semihiseri/invaderBot/README.md

# invadeableBot
Working directory for artificial invaders bots
