semihiseri/invaderBot/docs/driveWheel3.docx

# DLC: driveWheel3

This is the latest iteration of the driveWheel. Thanks to the the improved motor shaft connection design, you can now deliver more torque to the tracks when needed.

## Assembly Instructions

You will need…

- 1x driveWheel3 hub
- 1x M3x10 screw
- 1x driveWheel3

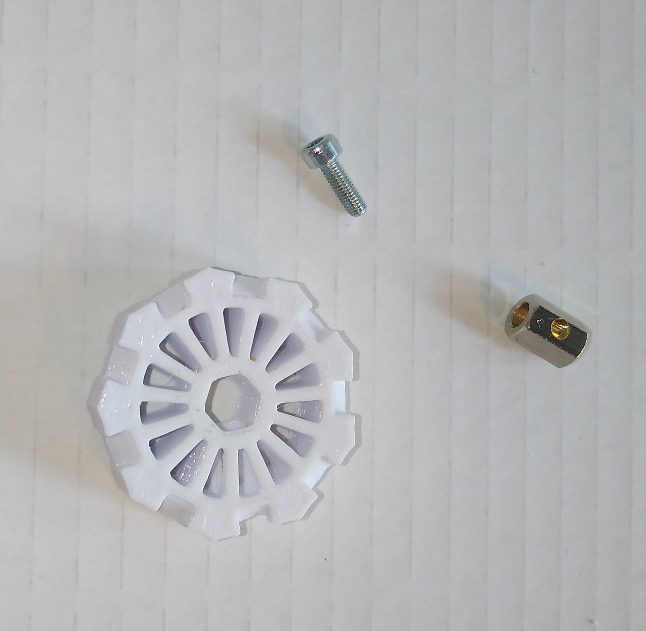
[picture p14: figure]
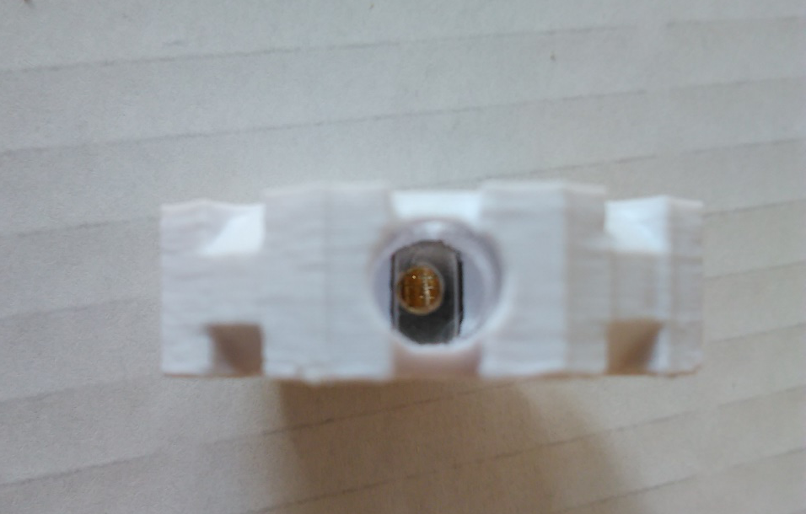
[picture p15: figure]

Align and insert the hub so that you

see the hole through the hole

my finger

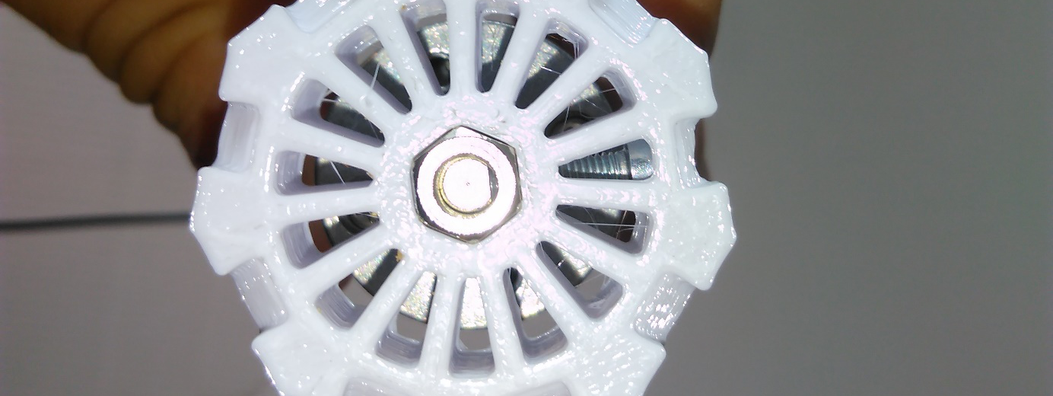
[picture p16: figure]

the flat side of shaft must be

perpendicular to the screw
