semihiseri/invaderBot/tubeAccessories.FCStd

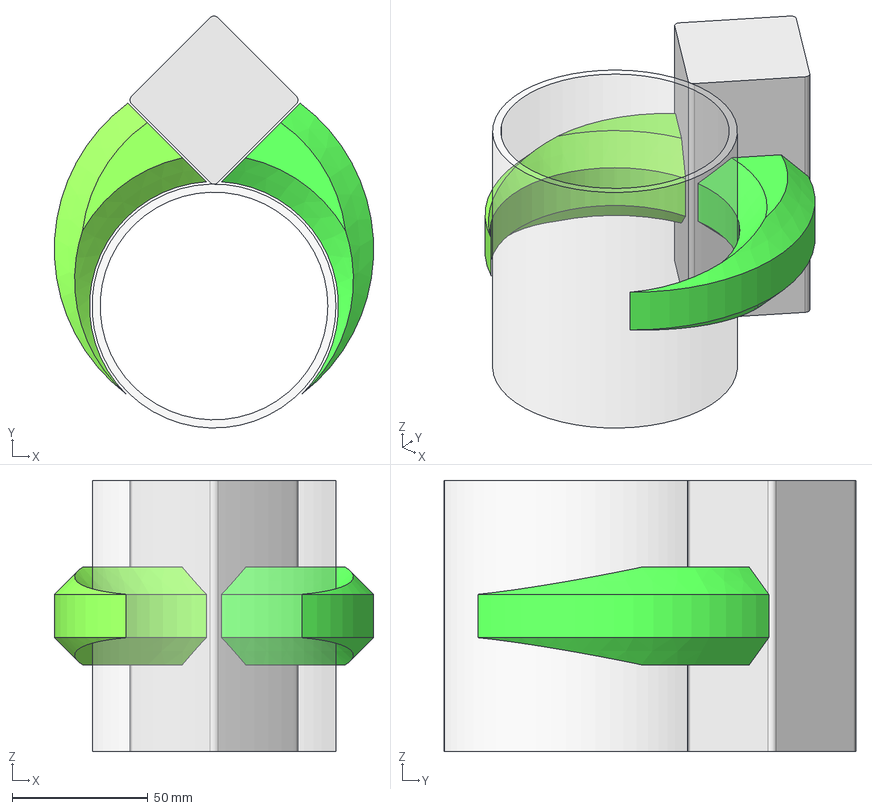
[picture p28: CAD file, 2019-10-02]
tubeAccessories.FCStd
117.7 x 152.0 x 100.0 mm
tube
profile
hand1
