semihiseri/invaderBot/drillTool.FCStd

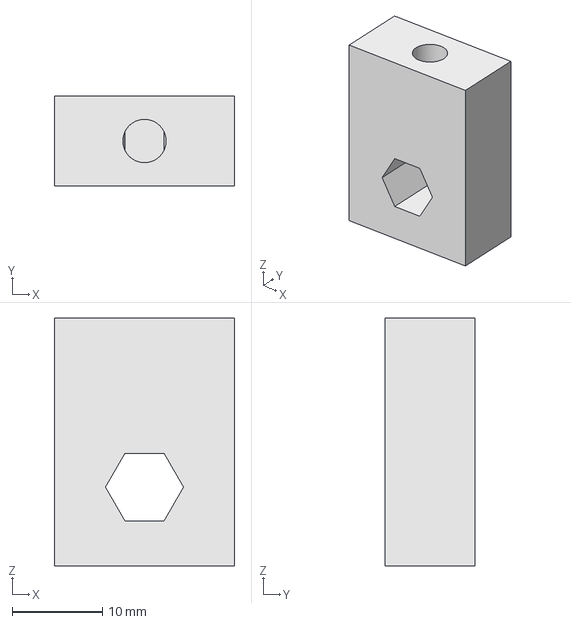
[picture p29: CAD file, 2019-09-19]
drillTool.FCStd
20.0 x 10.0 x 27.5 mm
