semihiseri/invaderBot/driveWheel3.FCStd

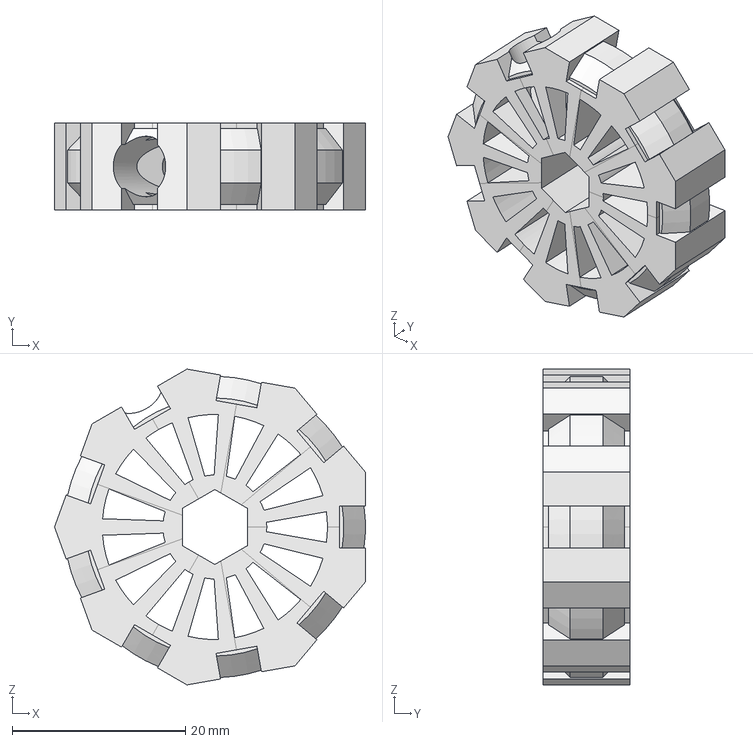
[picture p30: CAD file, 2019-09-19]
driveWheel3.FCStd
35.9 x 10.0 x 36.5 mm
