semihiseri/invaderBot/tensioner2.FCStd

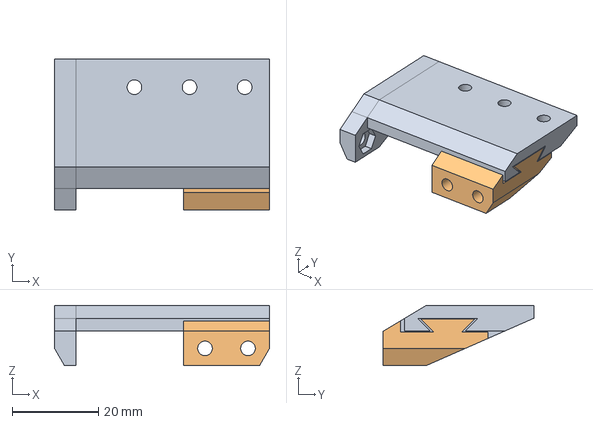
[picture p31: CAD file, 2019-09-15]
tensioner2.FCStd
50.0 x 35.0 x 14.0 mm
rail
slider
