semihiseri/invaderBot/driveWheel2.FCStd

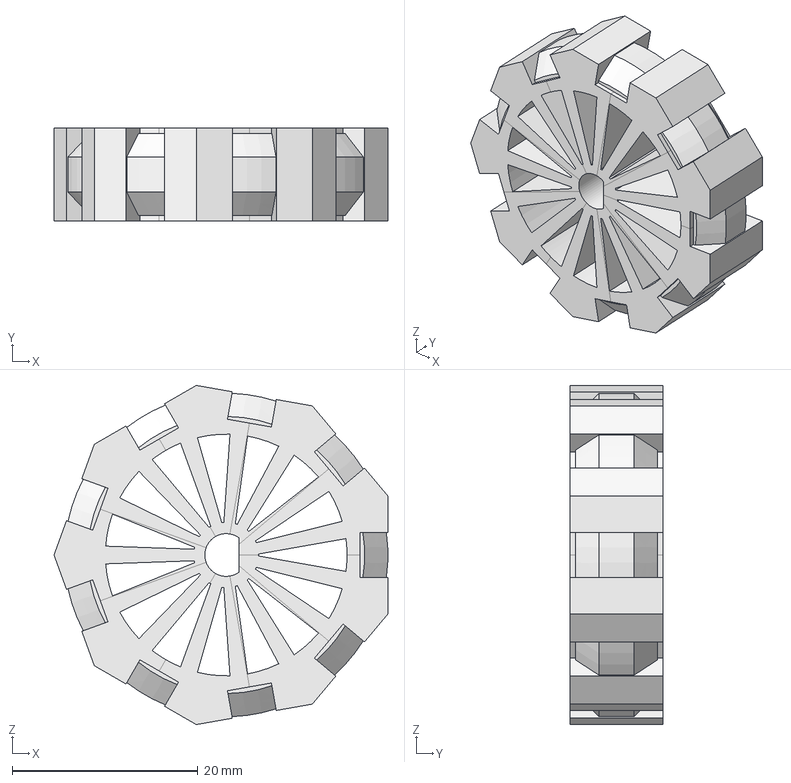
[picture p32: CAD file, 2019-09-03]
driveWheel2.FCStd
35.9 x 10.0 x 36.5 mm
