semihiseri/invaderBot/hinge.FCStd

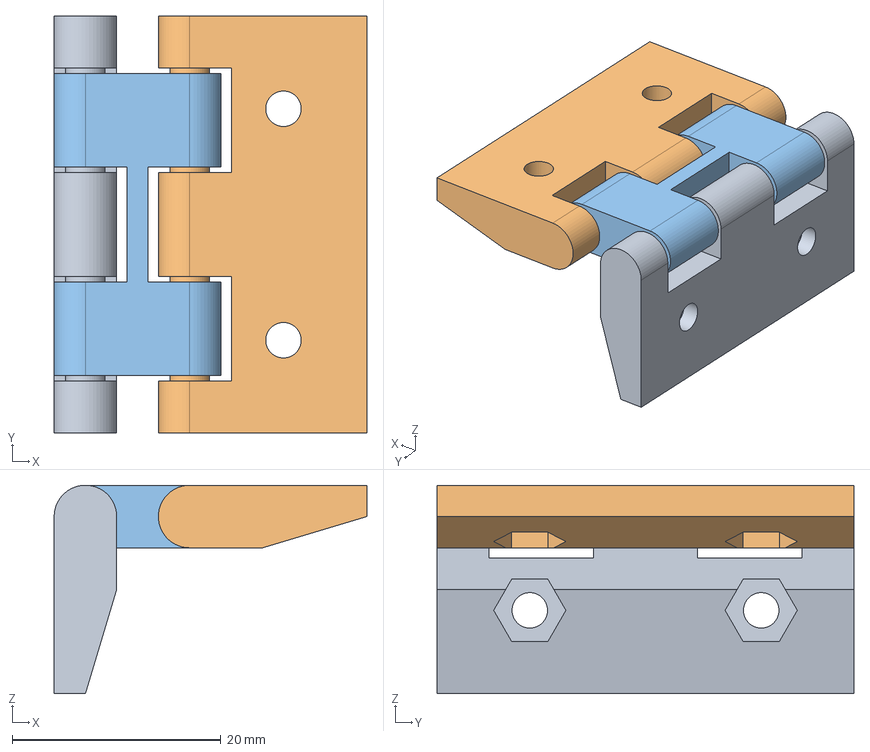
[picture p33: CAD file, 2019-08-29]
hinge.FCStd
30.0 x 40.0 x 20.0 mm
