semihiseri/invaderBot/motorMount3.FCStd

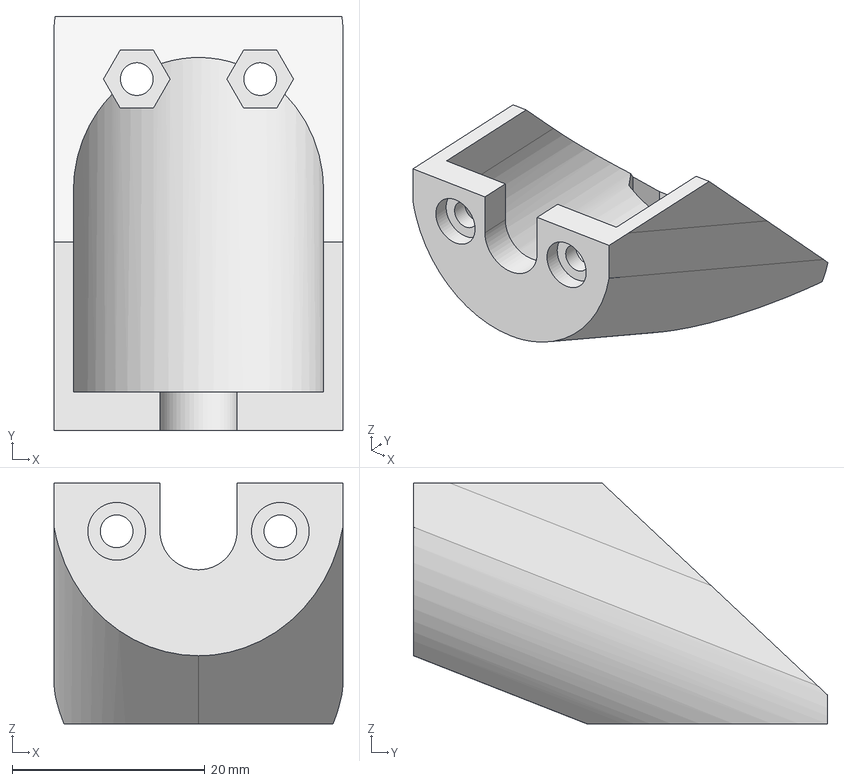
[picture p34: CAD file, 2019-08-29]
motorMount3.FCStd
30.0 x 43.0 x 25.0 mm
