semihiseri/invaderBot/cube2.FCStd

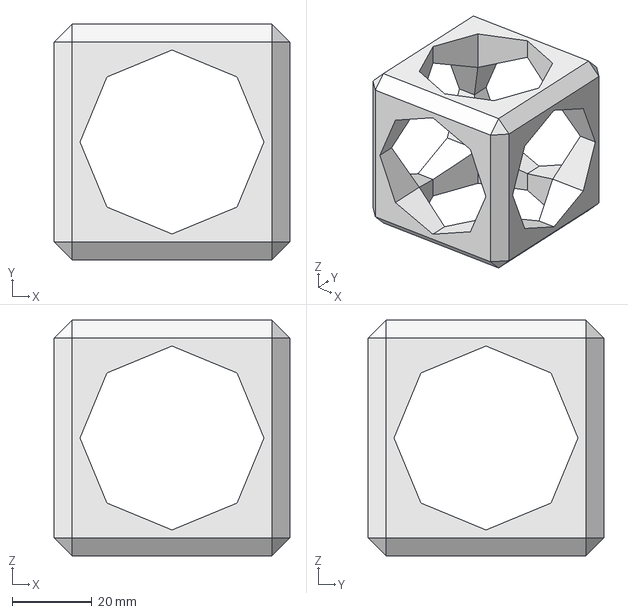
[picture p35: CAD file, 2019-08-04]
cube2.FCStd
59.0 x 59.0 x 59.0 mm
