semihiseri/invaderBot/cube.FCStd

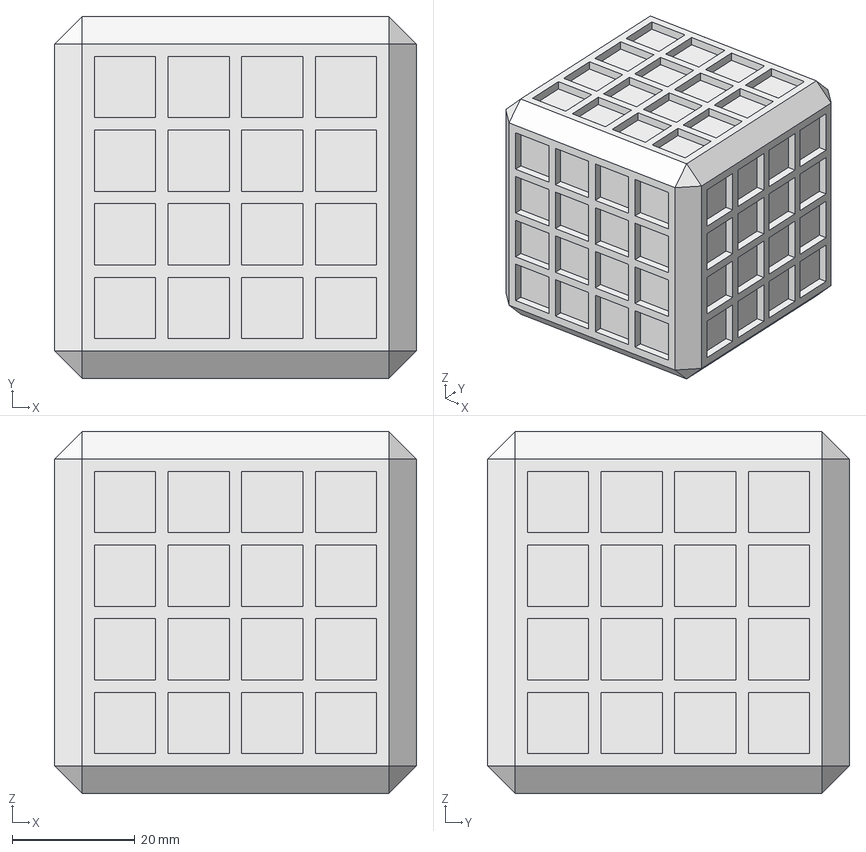
[picture p36: CAD file, 2019-08-04]
cube.FCStd
59.0 x 59.0 x 59.0 mm
