semihiseri/invaderBot/wheel2.FCStd

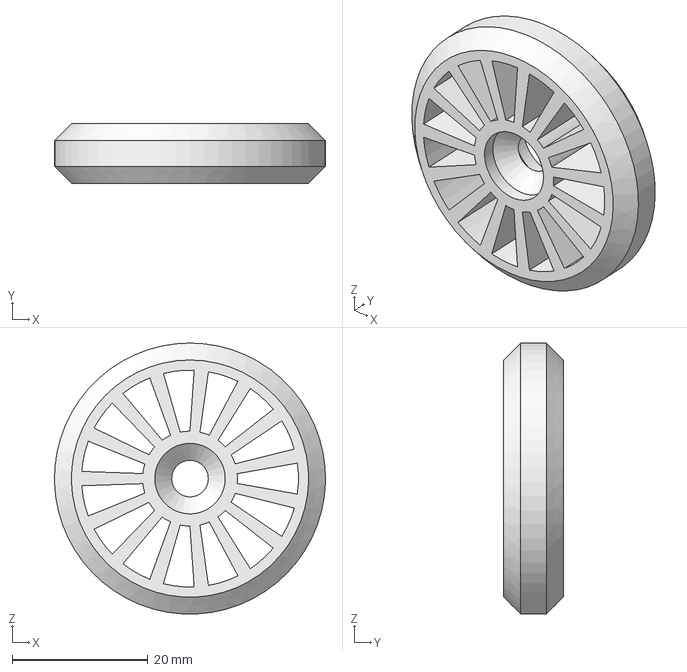
[picture p37: CAD file, 2019-04-27]
wheel2.FCStd
40.0 x 8.80 x 40.0 mm
