semihiseri/invaderBot/track3.FCStd

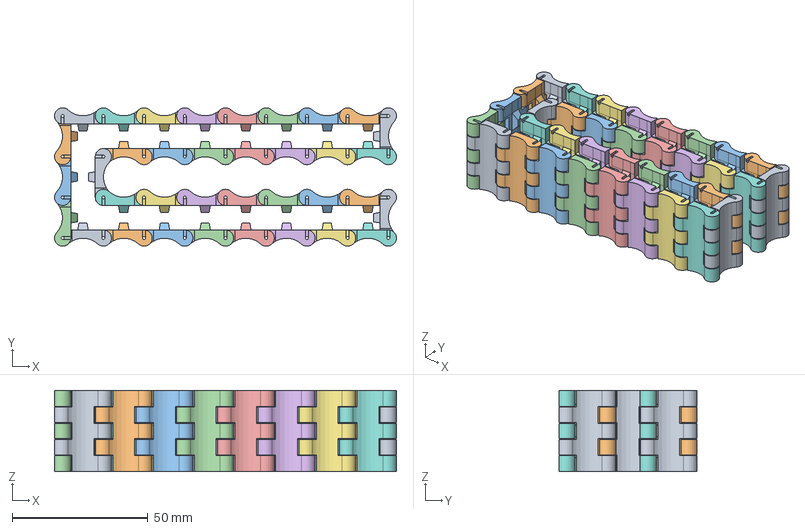
[picture p38: CAD file, 2019-04-27]
track3.FCStd
126.0 x 51.0 x 30.0 mm
