semihiseri/invaderBot/loadBlock.fcstd

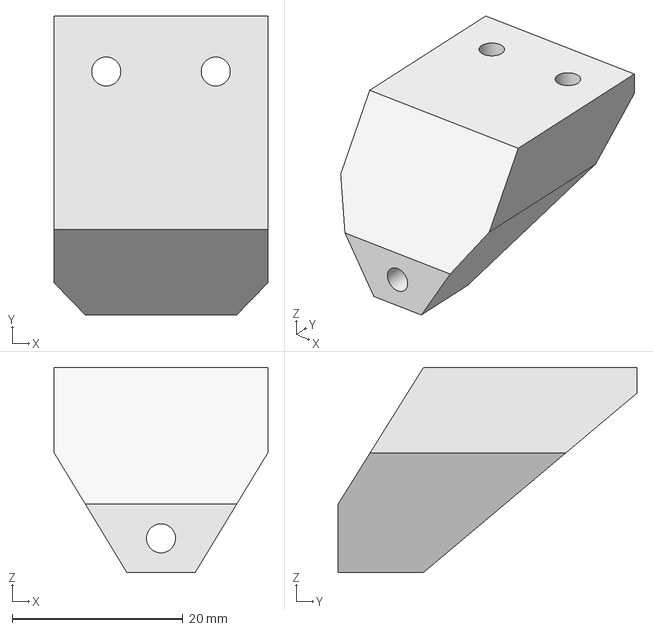
[picture p39: CAD file, 2019-04-27]
loadBlock.fcstd
25.0 x 35.0 x 24.0 mm
