semihiseri/invaderBot/docs/driveWheel3.pdf

## DLC: driveWheel3

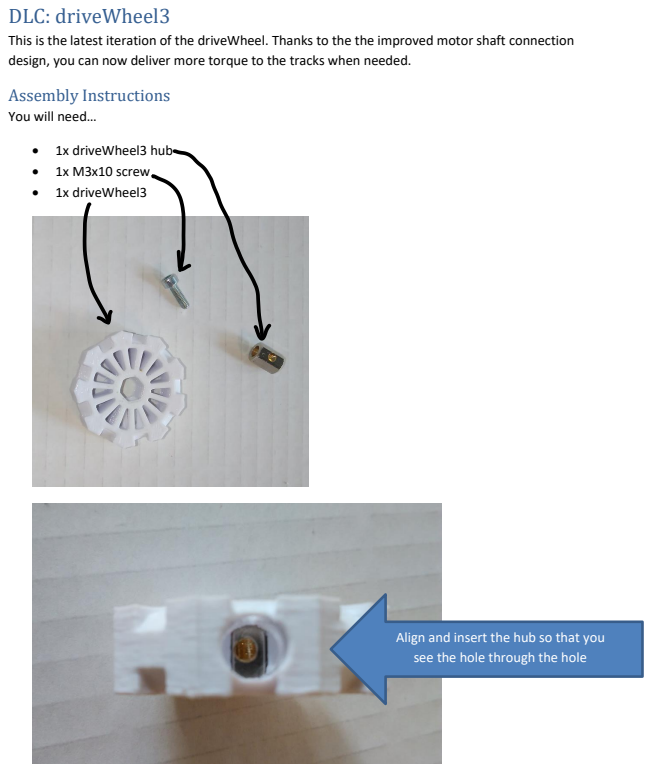
[picture p40: page 1]
• 1x driveWheel3 hub • 1x M3x10 screw • 1x driveWheel3

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

Assembly Instructions
You will need…

Align and insert the hub so that you
see the hole through the hole

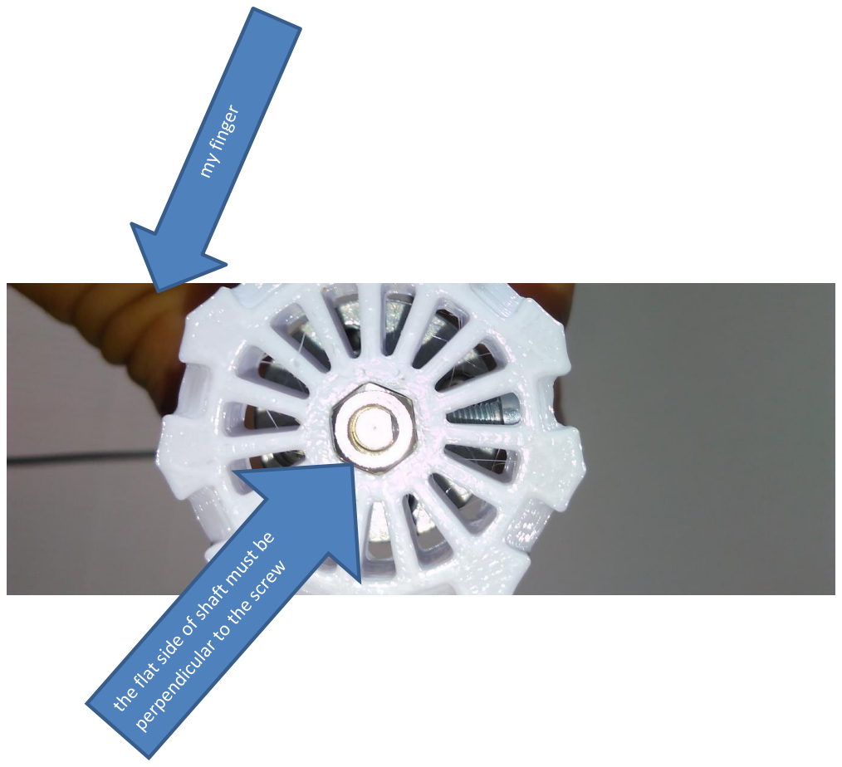
[picture p41: page 2]
