semihiseri/invaderBot/mainboard/autoshutoff-LTspice.asc

C1: cap; 100µ
C2: cap; 30p
R1: res; 100k
V1: voltage; 12
Named nets: 0, HV
.tran 10 startup
