semihiseri/invaderBot/mainboard/invaderBoard.kicad_pcb

## KiCad design mainboard/invaderBoard.kicad_pcb (2019-09-03)

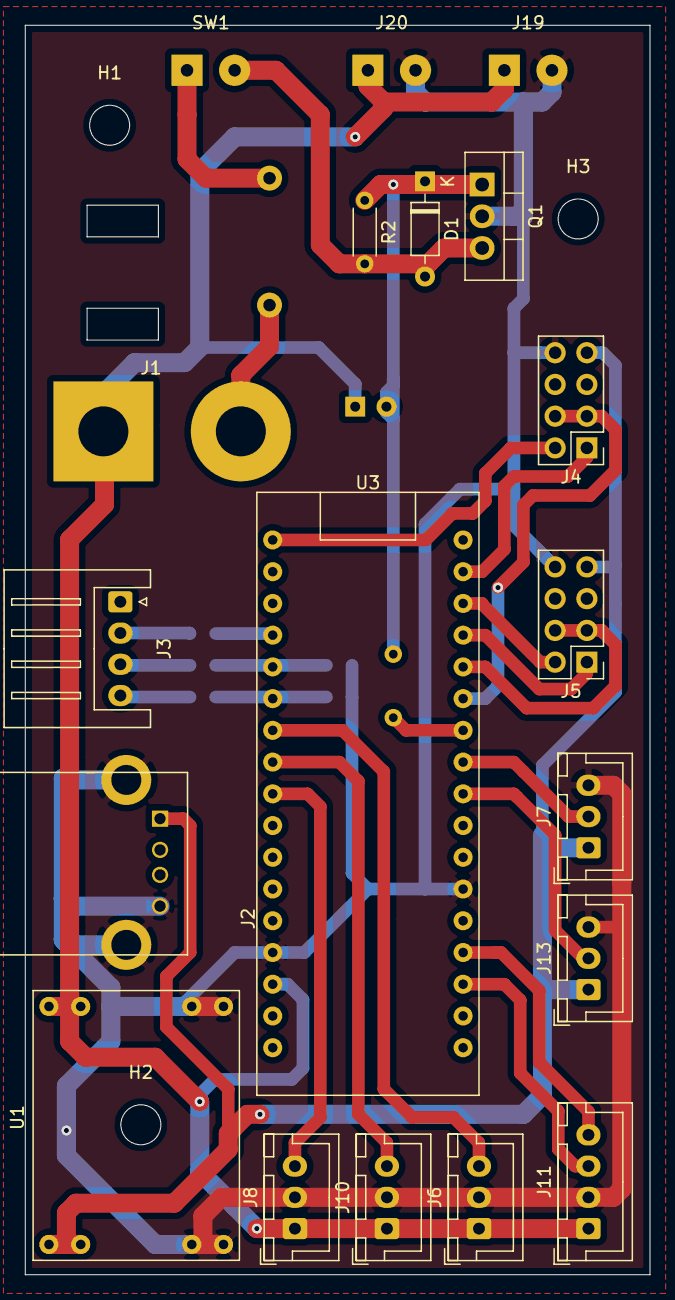
[picture p42: board invaderBoard.kicad_pcb from above]

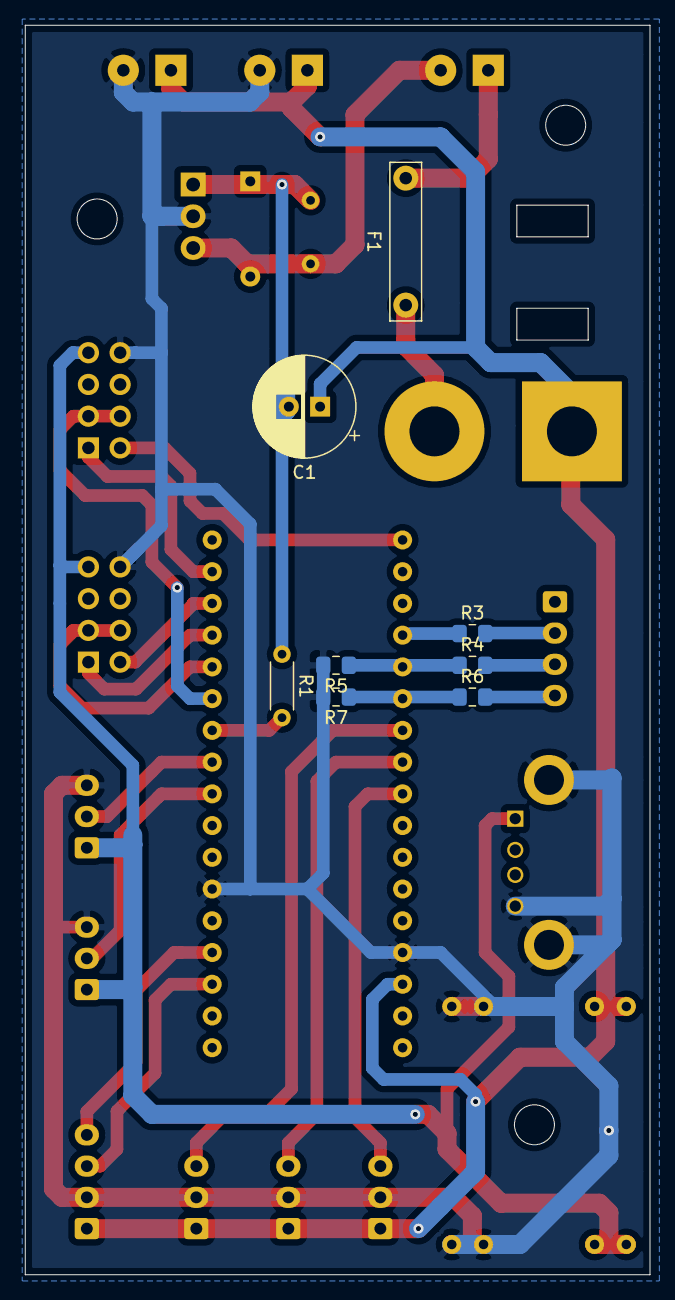
[picture p43: board invaderBoard.kicad_pcb from below]

Board: 2 copper layers, 50.0 x 100.0 mm, 30 parts (8 on the bottom side), 27 nets.

Parts:
C1: C; CP_Radial_D8.0mm_P2.50mm
D1: D; D_DO-35_SOD27_P7.62mm_Horizontal
F1: Polyfuse; PTC Fuse
H1, H2, H3: MountingHole; MountingHole_3.2mm_M3
J1: Conn_01x02; BiggerSolderPad
J2: USB_A
J3: Conn_01x04; JST_XH_S4B-XH-A_1x04_P2.50mm_Horizontal
J4, J5: Conn_02x04_Odd_Even; PinHeader_2x04_P2.54mm_Vertical
J6, J7, J8, J10, J13: Conn_01x03; JST_XH_B3B-XH-A_1x03_P2.50mm_Vertical
J11: Conn_01x04; JST_XH_B4B-XH-A_1x04_P2.50mm_Vertical
J19, J20: Conn_01x02; SolderWirePad_1x02_P3.81mm_Drill1mm
Q1: IRFZ44; TO-220-3_Vertical
R1, R2: R; R_Axial_DIN0204_L3.6mm_D1.6mm_P5.08mm_Horizontal
R3, R4, R5, R6, R7: R; R_0805_2012Metric_Pad1.15x1.40mm_HandSolder
SW1: SW_DIP_x01; SolderWirePad_1x02_P3.81mm_Drill1mm
U1: LM2596
U3: ArduinoMicro; Arduino Micro

Connections:
/5V: J2.1, J4.7, J5.7, J7.1, J13.1, U1.4
/BATT_CELL_1: J3.2, R3.2
/BATT_CELL_2: J3.3, R4.2
/BATT_CELL_3: J3.4, R6.2
/BATT_GND: D1.2, Q1.3, R2.2, SW1.2
/CELL_1: R3.1, U3.4
/CELL_2: R4.1, R5.1, U3.5
/CELL_3: R6.1, R7.1, U3.6
/GND: J2.4, J2.5, J4.8, J5.8, J6.2, J7.3, J8.2, J10.2, J11.2, J13.3, J19.2, J20.2, Q1.2, R5.2, R7.2, U1.1, U1.3, U3.14, U3.23
/HV: C1.1, J1.1, J6.1, J8.1, J10.1, J11.1, J19.1, J20.1, U1.2, U3.15
/LATCH_CTL: R1.2, U3.28
/LIGHT_DIN_1: J13.2, U3.26
/LIGHT_DIN_2: J7.2, U3.27
/M1_DIR: J4.3, J4.4, U3.29
/M1_LPWM: J4.2, U3.1
/M1_RPWM: J4.1, U3.33
/M2_DIR: J5.3, J5.4, U3.30
/M2_LPWM: J5.2, U3.32
/M2_RPWM: J5.1, U3.31
/USER_A3: J6.3, U3.7
/USER_A4: J10.3, U3.8
/USER_A5: J8.3, U3.9
/USER_RX: J11.4, U3.21
/USER_TX: J11.3, U3.20
unnamed: C1.2, D1.1, Q1.1, R1.1, R2.1
unnamed: F1.1, SW1.1
unnamed: F1.2, J1.2
