semihiseri/invaderBot/(commit log)

2019-04-06 track
    print in place track
    [track2.FCStd]
2019-04-27 initial loadblock
    [loadBlock.fcstd]
2019-04-27 track and wheel stuf added
    [track2.FCStd, track3.FCStd, wheel2.FCStd]
2019-04-28 files from old version -> tensioner and D coupling
    [3mmDcoupling.FCStd, tensioner.FCStd]
2019-04-28 new tensioner
    [tensioner.FCStd, tensioner2.FCStd]
2019-04-28 fixed interference between track and slider
    [tensioner2.FCStd]
2019-04-29 invaderboard initial commit
    [invaderBoard.kicad_pcb, invaderBoard.sch]
2019-04-30 kicad version 5 update
    [invaderBoard.sch]
2019-05-01 Motor coupling doned
    [driveWheel.FCStd, n20coupler.FCStd]
2019-05-16 first working combination
    [3mmDcoupling.FCStd, driveWheel.FCStd, driveWheel2.FCStd, motorDriverModel.FCStd, motorMount.FCStd, motorMount2.FCStd, rpiZeroModel.FCStd, tensioner2.FCStd]
2019-05-20 Notes to PCB design
    [invaderBoard.sch]
2019-07-23 Mainboard schematics mostly done
    [invaderBoard.sch]
2019-07-24 PCB mostly done, motor power outputs added to schematics
    [invaderBoard.kicad_pcb, invaderBoard.sch]
2019-08-04 Updated PCB - layout done, routing isn't
    [cube.FCStd, invaderBoard.kicad_pcb, invaderBoard.sch]
2019-08-04 a new cube added
    [cube2.FCStd]
2019-08-05 PCB Done, some changes on schematics
    [invaderBoard.kicad_pcb, invaderBoard.sch]
2019-08-05 PCB holes added + capacitor simulator in LTspice
    [invaderBoard.kicad_pcb, invaderBoard.sch]
2019-08-15 Manuf files created
    [invaderBoard-B_Cu.gbr, invaderBoard-B_Mask.gbr, invaderBoard-B_Paste.gbr, invaderBoard-B_SilkS.gbr, invaderBoard-Edge_Cuts.gbr, invaderBoard-F_Cu.gbr, invaderBoard-F_Mask.gbr, invaderBoard-F_Paste.gbr]
2019-08-29 some changes I guess
    [hinge.FCStd, motorMount3.FCStd]
2019-08-29 arduino FW added + some changes on sch.
    [invaderBoard-B_Cu.gbr, invaderBoard-B_Mask.gbr, invaderBoard-B_Paste.gbr, invaderBoard-B_SilkS.gbr, invaderBoard-Edge_Cuts.gbr, invaderBoard-F_Cu.gbr, invaderBoard-F_Mask.gbr, invaderBoard-F_Paste.gbr]
2019-09-03 PCB updated -v1 finalized
    [driveWheel2.FCStd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]
2019-09-15 Some more changes
    [tensioner2.FCStd]
2019-09-15 improved arduino code
2019-09-16 Obsolete drawings removed
    [motorDriverModel.FCStd, motorMount.FCStd, motorMount2.FCStd, rpiZeroModel.FCStd]
2019-09-16 More obsolete drawings removed
    [driveWheel.FCStd, n20coupler.FCStd]
2019-09-17 drill tool added
    [drillTool.FCStd]
2019-09-17 drill tool modification
    [drillTool.FCStd]
2019-09-19 driveWheel3 + more documentation
    [driveWheel3.FCStd]
2019-10-02 Tubeholder added and maybe 1-2 more things
    [tubeAccessories.FCStd]
2019-10-03 Battery level can be retrieved via arduino. Also robot-going-crazy is fixed in kbctl
    [invaderBot_arduino.ino, run.py]
2019-10-12 firmware for alternative arduino uno solution added
